OpenBCI/OpenBCI_Wifi_Shield/openbci_wifi_bom.xlsx

Item | Reference | Value | Thing | Part Number | Manufacturer | Footprint | Quantity | Cosigned by OpenBCI
2 | P8,P7 | CONN_01X08 | Socket_Strip_Straight_1x08 0.1” pitch |  |  | Socket_Strips:Socket_Strip_Straight_1x08 | 2 | YES
3 | P1 | CONN_01X04 | Socket_Strip_Straight_1x04 0.1” pitch | PPTC041LFBN-RC | Sullins | Socket_Strips:Socket_Strip_Straight_1x04 | 1
3 | P9,P10 | CONN_01X04 | Socket_Strip_Straight_1x04 0.1” pitch |  |  | Socket_Strips:Socket_Strip_Straight_1x04 | 2 | YES
4 | P4,P6,P5 | CONN_01X02 | Socket_Strip_Straight_1x02 0.1” pitch |  |  | Socket_Strips:Socket_Strip_Straight_1x02 | 3 | YES
5 | C1 | 0.1uF | C_0603 | GRM188R71H104KA93D | Murata | Capacitors_SMD:C_0601 | 1
6 | C2 | 1uF | C_0603 | GRM188R61E105KA12D | Murata | Capacitors_SMD:C_0602 | 1
7 | C3 | 10uF | C_0603 | GRM188C80G106ME47D | Murata | Capacitors_SMD:C_0603 | 1
8 | C4 | 100uF | C_1210 | JMK325ABJ107MM-P | Taiyo Yuden | Capacitors_SMD:C_1210 | 1
8 | D1 | MBR120 | D_SOD-123FL | MBR120VLSFT3G | ON Semiconductor (http://www.mouser.com/onsemiconductor/) | kicad-libraries-master:SOD-123FL | 1
9 | D2,D3,D5 | LED | C_0603 | LTST-C193TBKT-5A | Lite-On | Capacitors_SMD:C_0603 | 3
10 | P2 | CONN_01X04 | JST_RA_SMT | S2B-PH-SM4-TB(LF)(SN) | Various | OpenBCI:JST_RA_SMT | 1
11 | R1,R2,R5,R6,R7 | 10K | R_0603 | ERJ-3EKF1002V | Panasonic | Resistors_SMD:R_0603 | 5
12 | R3,R4,R8 | 1k | R_0603 | ERJ-3EKF1001V | Panasonic | Resistors_SMD:R_0603 | 3
14 | SW1,SW2 | TACT_SWITCH | PTS810 | PTS810 SJK 250 SMTR LFS | C&K Components | OpenBCI:PTW810 | 2
1 | SW3 | SPDT | SPDT Power Switch | PCM12SMTR | C&K Components | OpenBCI_Wifi_Shield:PCM12SMTR | 1
1 | SW4 | CJS1200 | Dip switch | CJS1200 | Alps | OpenBCI:CJS-1200TA | 1
13 | U2 | AP2112 | SOT-23-5 | AP2112K-3.3TRG1 | Diodes Inc. | TO_SOT_Packages_SMD:SOT-23-5 | 1
15 | U1 | ESP-12E | ESP-12E-SMD |  |  | OpenBCI_Wifi_Shield:ESP-12E-SMD | 1 | YES
