OpenBCI/OpenBCI_Wifi_Shield/OpenBCI_Wifi_Shield.pdf

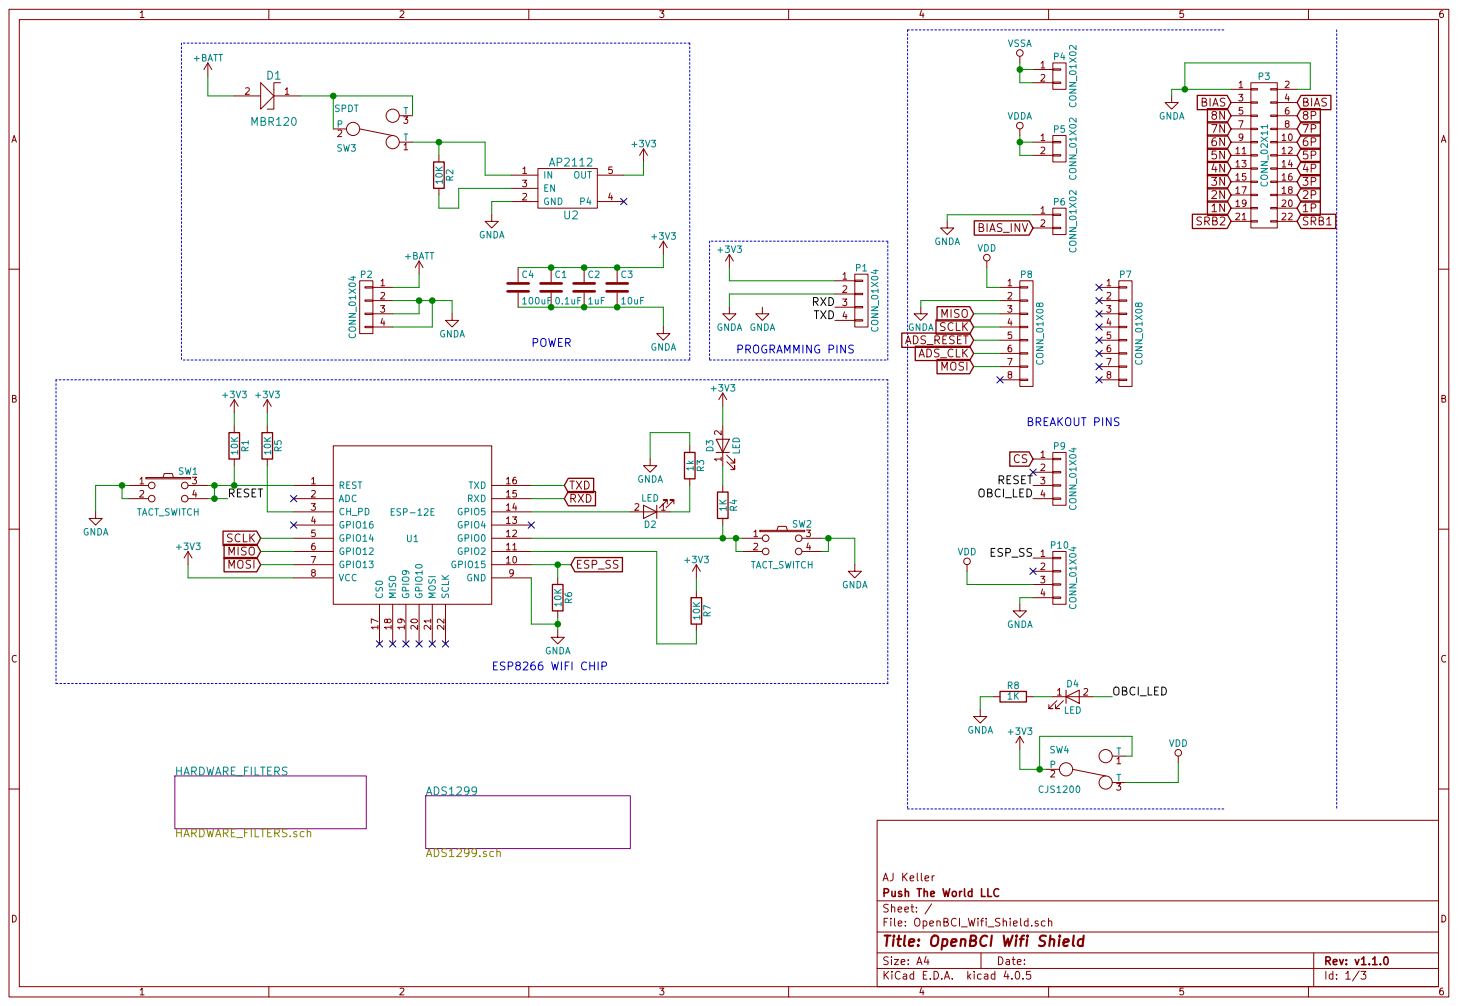
[picture p1: page 1]

AJ Keller
File: OpenBCI_Wifi_Shield.sch Sheet: / Push The World LLC

Id: 1/3 Title: OpenBCI Wifi Shield

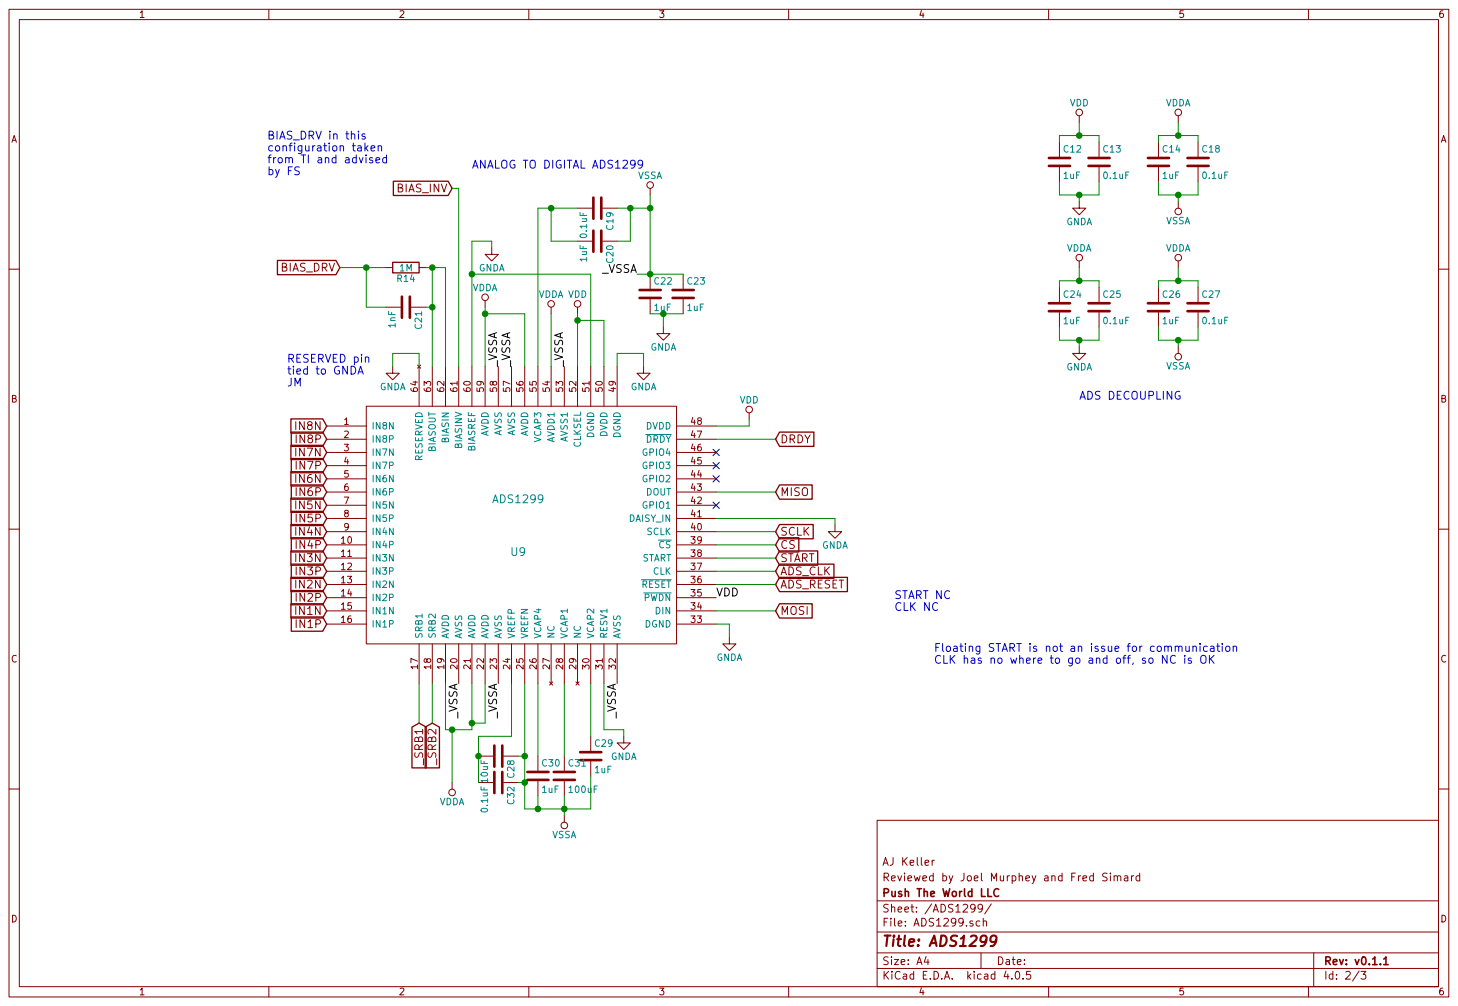
[picture p2: page 2]

BIAS_DRV in this
configuration taken
from TI and advised

VDD

1uF GNDA _VSSA _VSSA

CLK has no where to go and off, so NC is OK

File: ADS1299.sch Sheet: /ADS1299/ Push The World LLC

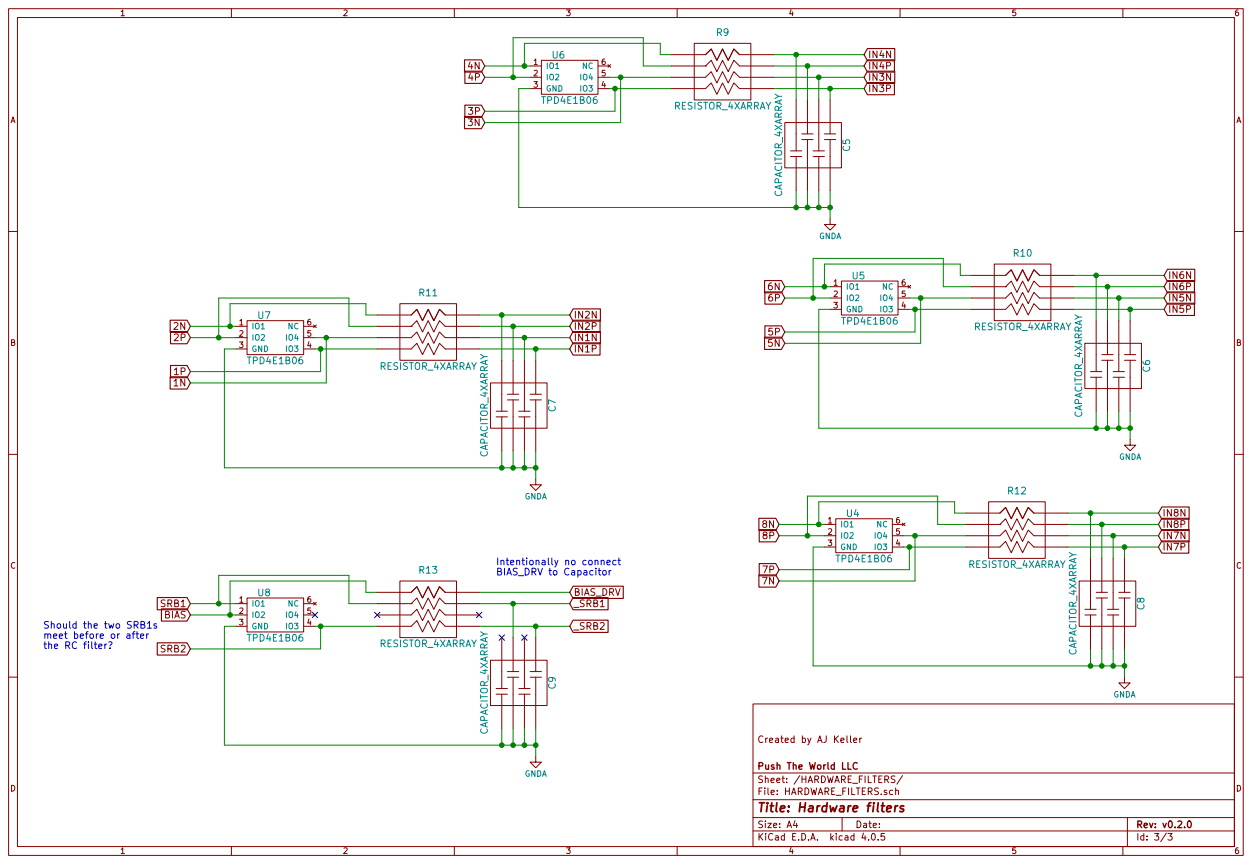
[picture p3: page 3]

Created by AJ Keller

Sheet: /HARDWARE_FILTERS/ Push The World LLC

File: HARDWARE_FILTERS.sch
Id: 3/3 Title: Hardware filters
