OpenBCI/OpenBCI_Wifi_Shield/CHANGELOG.md

# v0.3.2

### Bug fixes
* Moved P4, P5, and P10

# v0.3.1

### General Notes
* Fixed JST pad
* Extended copper layer
* Fix silk screens
