OpenBCI/OpenBCI_Wifi_Shield/(threads)

Thread 7 (2025-05-07):

PCB board components outside the board outline fix

tudorao, 2025-05-07:
[OpenBCI_Wifi_Shield_61.214x61.214mm_for_JLCPCB.zip](https://github.com/user-attachments/files/20087113/OpenBCI_Wifi_Shield_61.214x61.214mm_for_JLCPCB.zip)

tudorao, 2025-05-07:
I try to fix it I do not know if work! I ordered and did try to see if works but it is something instead of nothing. It is the ADS1299 and WiFi ESP32-12E on one PCB accordingly with the schematics on GitHub. so WIFI   + Daisy Module in one board. It may work if not populate the  ADS1299 and Daisy Module components . I do not know do it on your risk! I am not responsible for the files! I do not assume any responsibility!
