OpenBCI/OpenBCI_Wifi_Shield/(commit log)

2017-01-20 Initial upload
    [OpenBCI_Wifi_Shield.kicad_pcb, OpenBCI_Wifi_Shield.sch]
2017-01-20 update readme with kicad
2017-01-24 Update after first review with joel
    [OpenBCI_Wifi_Shield.sch, _saved_OpenBCI_Wifi_Shield.sch]
2017-01-24 Add programming pins
    [OpenBCI_Wifi_Shield.sch]
2017-01-24 Brought in board template
    [Ganglion_01_Template.sch, _saved_OpenBCI_Wifi_Shield.sch]
2017-01-25 Finish routing
    [OpenBCI_Wifi_Shield.kicad_pcb, _saved_OpenBCI_Wifi_Shield.sch]
2017-01-25 Place name
    [OpenBCI_Wifi_Shield.kicad_pcb]
2017-01-25 Add SW3 power switch
    [OpenBCI_Wifi_Shield.sch]
2017-01-25 Laid out the sw3 and fixed jst power pin issue
    [OpenBCI_Wifi_Shield.kicad_pcb]
2017-01-25 Redo pcb after joel meeting
    [OpenBCI_Wifi_Shield.csv, OpenBCI_Wifi_Shield.kicad_pcb, OpenBCI_Wifi_Shield.sch]
2017-01-25 Update to fix split in copper pour
    [OpenBCI_Wifi_Shield.kicad_pcb]
2017-01-25 Bumpp version v0.1.2
    [OpenBCI_Wifi_Shield.kicad_pcb, OpenBCI_Wifi_Shield.sch]
2017-01-25 nice pours
    [OpenBCI_Wifi_Shield.kicad_pcb]
2017-01-26 Enh joel revs and add silk names
    [OpenBCI_Wifi_Shield.kicad_pcb, OpenBCI_Wifi_Shield.sch]
2017-01-26 fix pours to be the same and moved on off text away from edge
    [OpenBCI_Wifi_Shield.kicad_pcb]
2017-01-27 Update diode to SOD-123FL from SOD-123
    [OpenBCI_Wifi_Shield.kicad_pcb, OpenBCI_Wifi_Shield.sch]
2017-02-07 Add two pull up resistors, one pull down, and an LED
    [OpenBCI_Wifi_Shield.kicad_pcb, OpenBCI_Wifi_Shield.sch]
2017-02-22 Prototype v0.1.2 revisions bump version to v0.2.0
    [OpenBCI_Wifi_Shield.kicad_pcb, OpenBCI_Wifi_Shield.sch, openbci_wifi_bom.xlsx]
2017-02-22 Bump to v0.2.1 add thru holes back in and keep dip switch power ctrl
    [OpenBCI_Wifi_Shield.kicad_pcb, OpenBCI_Wifi_Shield.sch]
2017-02-23 Started routing need to finalize pass thru header positions
    [OpenBCI_Wifi_Shield.kicad_pcb, OpenBCI_Wifi_Shield.sch]
2017-02-24 finished new layout
    [OpenBCI_Wifi_Shield.kicad_pcb]
2017-02-24 ready for review
    [OpenBCI_Wifi_Shield.kicad_pcb]
2017-02-25 Add reset route to wifi and openbci
    [OpenBCI_Wifi_Shield.kicad_pcb, OpenBCI_Wifi_Shield.sch]
2017-03-12 update bom
    [openbci_wifi_bom.xlsx]
2017-03-12 Bump version to 0.3.0 and fix D5 led
    [OpenBCI_Wifi_Shield.kicad_pcb, OpenBCI_Wifi_Shield.sch]
2017-03-23 Beta board v0.3.1
    [Ganglion_01_Template.sch, OpenBCI_Wifi_Shield.kicad_pcb, OpenBCI_Wifi_Shield.sch, openbci_wifi_bom.xlsx]
2017-03-24 Adjust headsers
    [OpenBCI_Wifi_Shield.kicad_pcb]
2017-04-07 Updated bom
    [openbci_wifi_bom.xlsx]
2017-05-08 Updating power switch
2017-05-08 Updated schematic with new switch and had to change some footpritns
    [OpenBCI_Wifi_Shield.kicad_pcb, OpenBCI_Wifi_Shield.sch]
2017-05-08 Bump version to 1.0.0 for first release
    [OpenBCI_Wifi_Shield.csv, OpenBCI_Wifi_Shield.sch, openbci_wifi_bom.xlsx]
2017-09-07 ADD: New ADS1299 chip
    [ADS1299.sch, HARDWARE_FILTERS.sch, OpenBCI_Wifi_Shield.sch]
2017-09-12 FIX: Finish DRC
    [ADS1299.sch, HARDWARE_FILTERS.sch, OpenBCI_Wifi_Shield.sch]
2017-12-07 ADD: ADS
    [HARDWARE_FILTERS.sch, OpenBCI_Wifi_Shield.kicad_pcb, openbci_wifi_bom.xlsx]
